zetof/herbs-with-brains/documents/cout-proto.ods

Coûts de construction de l'unité hydroponique – Prototype
Libellé | Prix unitaire | Quantité | Total | Remarque
Table à marée | 49,00 € | 1 | 49,00 € | bac récupérateur
Table de culture | 15,00 € | 1 | 15,00 € | bac semis
Armoire
Panneau OSB 3 | 24,90 € | 2 | 49,80 € | 3 plateaux
Chevron sapin 50x50 | 5,15 € | 2 | 10,30 € | 4 montants
Panneau polystyrène extrudé | 3,97 € | 6 | 23,82 € | 3 côtés
Plaque PMMA – plexiglas | 43,97 € | 1 | 43,97 € | 1mx1m, la porte doit être plus petite que prévue
 |  |  | 127,89 €
Cylindre de culture
PVC rigide 5mm 1mx1m | 45,00 € | 2 | 90,00 € | les deux portes tube circulaires
PVC rigide 5mm 1mx0,5m | 22,50 € | 1 | 22,50 € | les supports en croix haut et bas
Tuyau PVC rigide 100mm 4m | 5,50 € | 1 | 5,50 € | tube central
Tuyau PVC rigide 100mm 4m | 4,90 € | 5 | 24,50 € | tubes de culture
Roulette à bille | 1,69 € | 6 | 10,14 € | roulements
 |  |  | 152,64 €
Circulation eau
Pompe 1000l/h | 19,90 € | 1 | 19,90 €
Tuyau semi rigide 16mm / m | 0,90 € | 2 | 1,80 €
Tuyau PVC 4mm / m | 0,50 € | 10 | 5,00 €
Tête de distribution 12 sorties | 1,50 € | 1 | 1,50 €
Collier de serrage 16mm | 0,50 € | 2 | 1,00 €
 |  |  | 29,20 €
Sondes
pH + conductivity sensors | 99,00 € | 1 | 99,00 €
Humidité + température | 1,95 € | 1 | 1,95 €
Température de l'eau | 4,89 € | 1 | 4,89 €
Détection niveau d'eau | 1,65 € | 2 | 3,30 € | capteur haut et bas
 |  |  | 109,14 €
Actions
Résistance chauffante | 17,66 | 1 | 17,66 €
Ventilateur | 5,89 | 3 | 17,67 € | 2 pour l'unité plus une pour les alimentations
LED | 14,78 | 10 | 147,80 €
Électrovanne | 5,41 | 2 | 10,82 € | 12V DC – 1 pour le niveau d'eau, une pour le bac à semis
 |  |  | 193,95 €
Informatique
Raspberry PI | 39,9 | 1 | 39,90 €
Arduino uno | 7,59 | 2 | 15,18 €
 |  |  | 55,08 €
Alimentation
12v – 40A | 22,84 | 1 | 22,84 €
5v – 50W | 12,59 | 1 | 12,59 €
 |  |  | 35,43 €
 |  | TOTAL : | 767,33 €
