zetof/herbs-with-brains/freecad/modeles/assemblage.fcstd

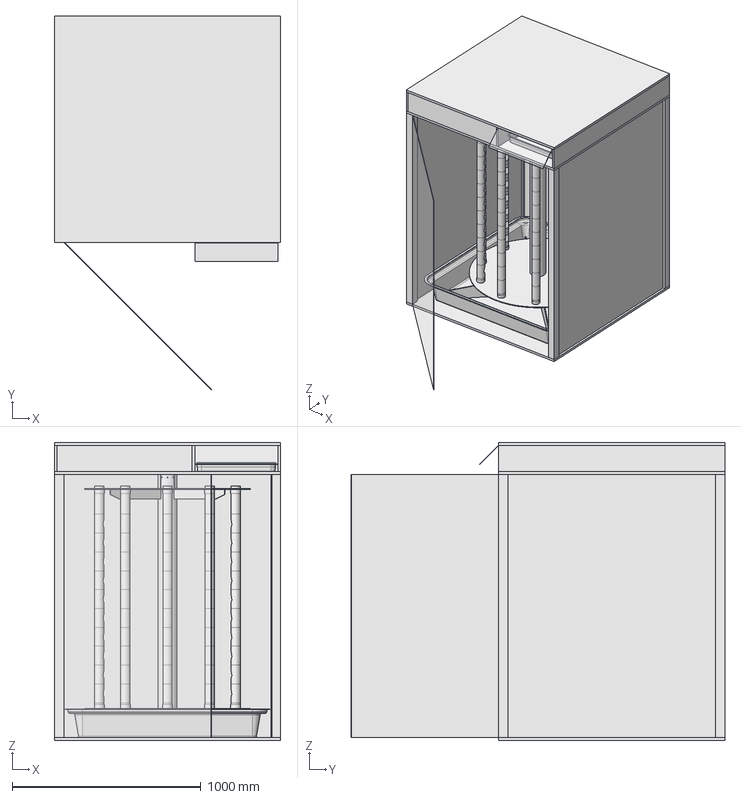
[picture p13: CAD file, 2016-10-27]
freecad/modeles/assemblage.fcstd
1200.0 x 1981.5 x 1580.0 mm
disque_inferieur
bille
corps
percage_base
bille001
corps001
percage_base001
bille002
corps002
percage_base002
bille003
corps003
percage_base003
bille004
corps004
percage_base004
bille005
corps005
percage_base005
porte_tubes_inferieur
porte_tubes_superieur
support_bas_1
support_bas_2
tube_culture_1
tube_culture_2
tube_culture_3
tube_culture_4
tube_culture_5
tube_culture_6
tube_culture_7
tube_culture_8
tube_culture_9
tube_culture_10
support_haut_1
support_haut_2
tube_central
plateau_bas
plateau_intermediaire
plateau_haut
bac_semis
bac_recuperateur
cote_droit
cote_gauche
face_avant
cote_arriere
cote_milieu
montant_arriere_gauche
montant_arriere_droit
montant_avant_gauche
montant_avant_droit
paroi_fond
paroi_droite
paroi_gauche
porte
porte_semis
