zetof/herbs-with-brains/freecad/export_assemblage/support_1.step

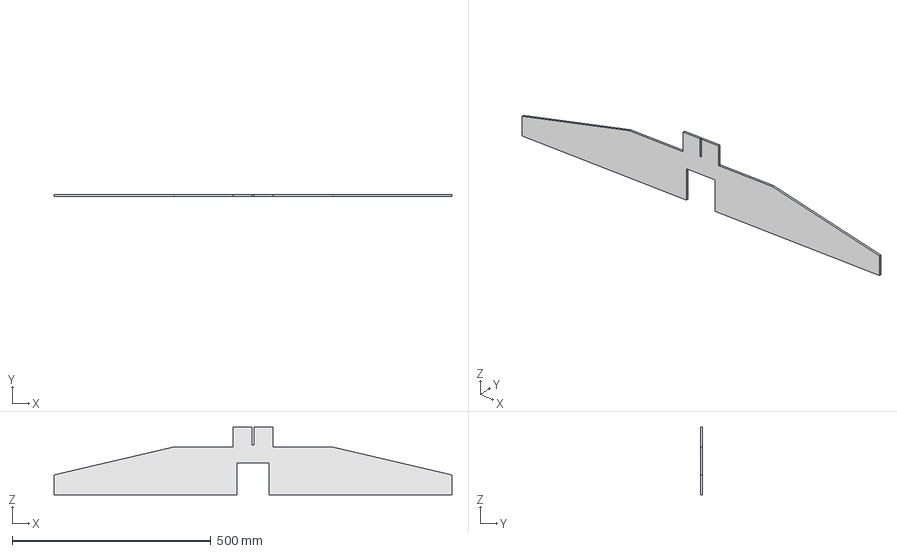
[picture p14: CAD file, 2016-12-03]
freecad/export_assemblage/support_1.step
1000.0 x 5.00 x 170.0 mm
