zetof/herbs-with-brains/freecad/export_assemblage/cote_superieur.step

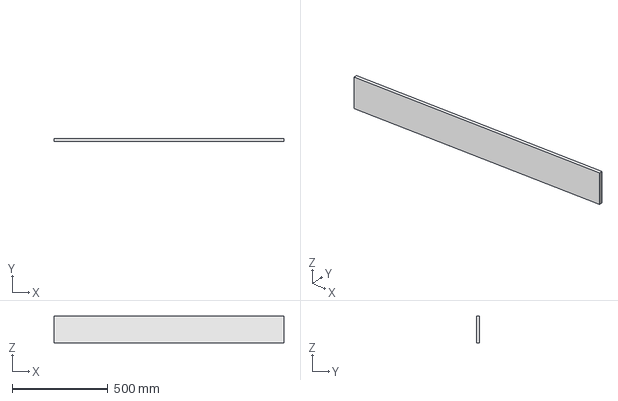
[picture p15: CAD file, 2016-10-27]
freecad/export_assemblage/cote_superieur.step
1200.0 x 15.0 x 140.0 mm
