zetof/herbs-with-brains/freecad/modeles/porte.fcstd

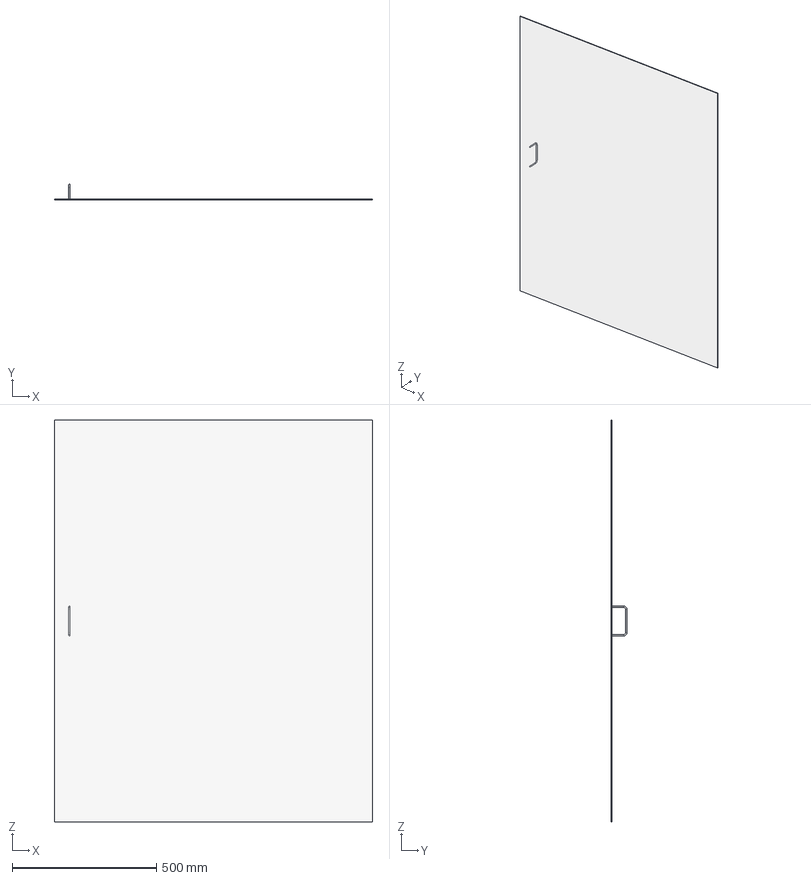
[picture p16: CAD file, 2016-10-27]
freecad/modeles/porte.fcstd
1105.0 x 55.5 x 1395.0 mm
porte
poignee
