zetof/herbs-with-brains/freecad/export_assemblage/face_avant.step

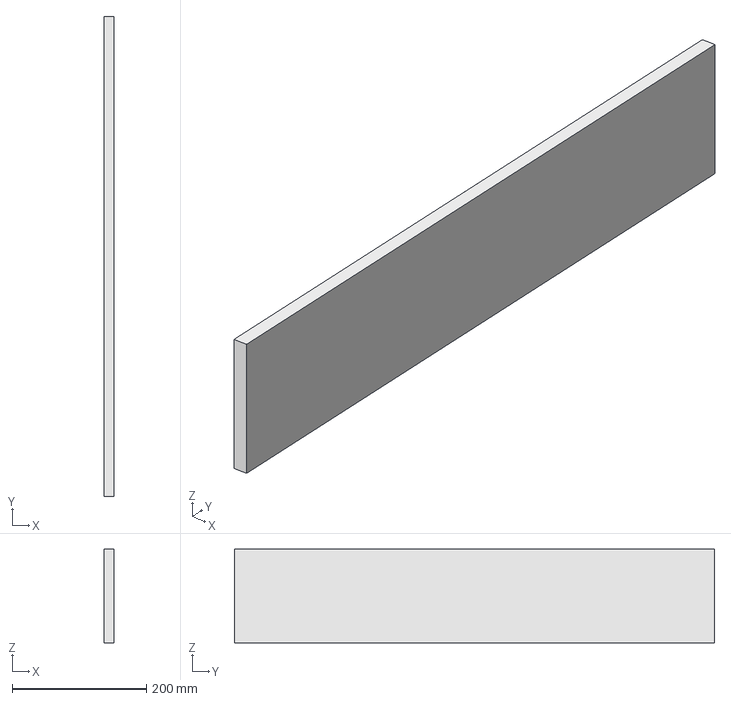
[picture p17: CAD file, 2016-10-27]
freecad/export_assemblage/face_avant.step
15.0 x 715.0 x 140.0 mm
