zetof/herbs-with-brains/freecad/modeles/bac.fcstd

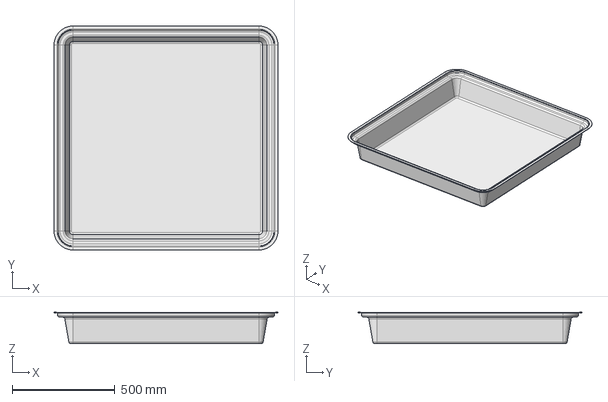
[picture p18: CAD file, 2016-10-27]
freecad/modeles/bac.fcstd
1088.0 x 1088.0 x 152.2 mm
