zetof/herbs-with-brains/freecad/export_assemblage/cote_superieur_milieu.step

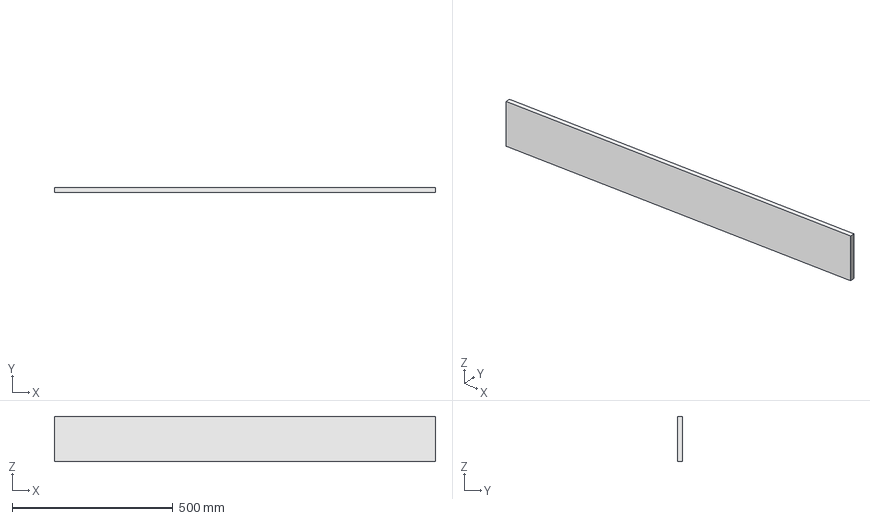
[picture p19: CAD file, 2016-10-27]
freecad/export_assemblage/cote_superieur_milieu.step
1185.0 x 15.0 x 140.0 mm
