zetof/herbs-with-brains/freecad/modeles/petit_bac.fcstd

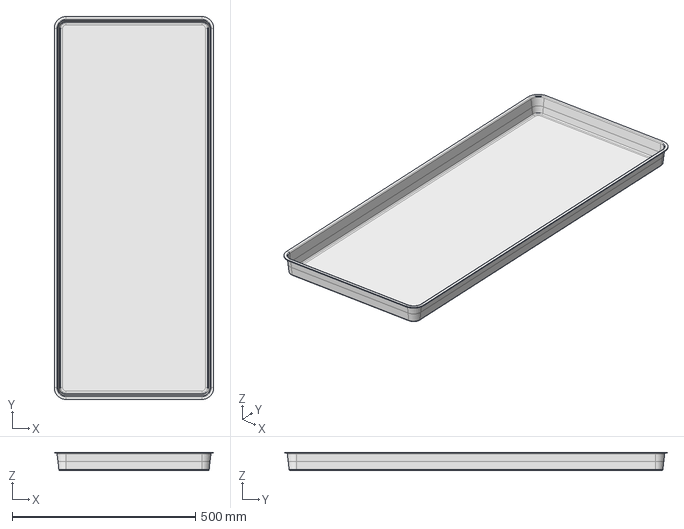
[picture p20: CAD file, 2016-10-27]
freecad/modeles/petit_bac.fcstd
435.3 x 1045.3 x 50.0 mm
