zetof/herbs-with-brains/freecad/export_assemblage/paroi.step

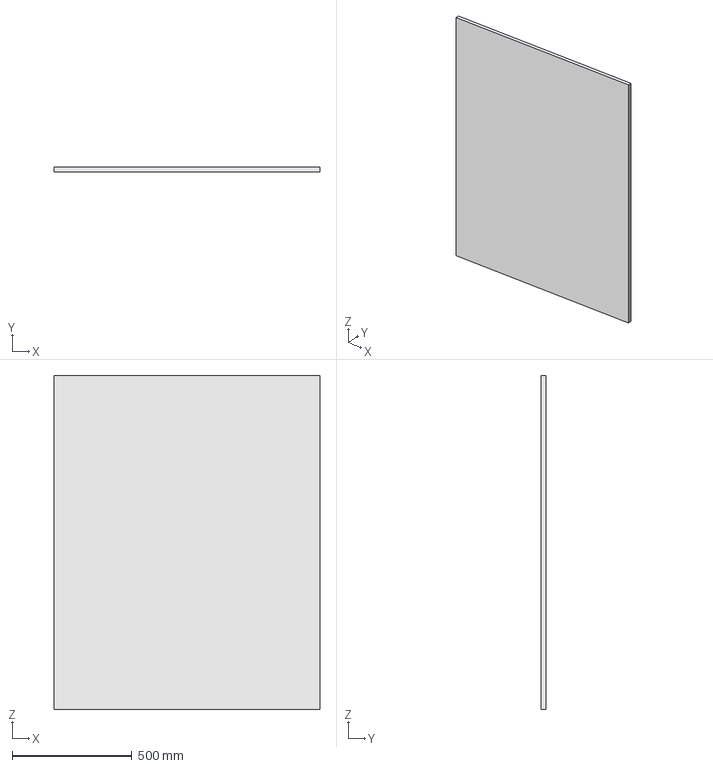
[picture p21: CAD file, 2016-10-27]
freecad/export_assemblage/paroi.step
1110.0 x 20.0 x 1395.0 mm
