zetof/herbs-with-brains/freecad/modeles/plateau_troue.fcstd

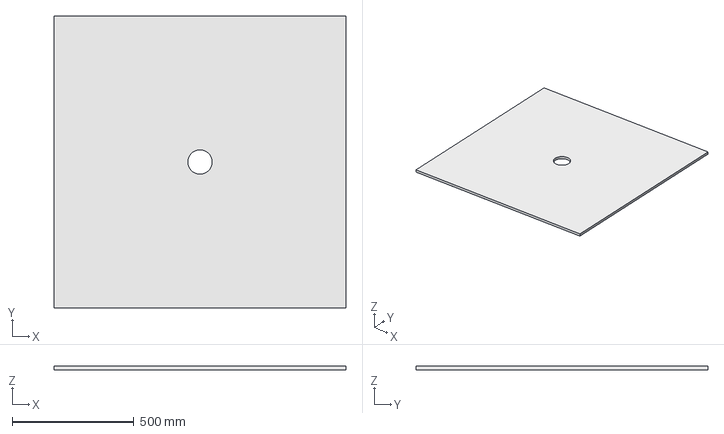
[picture p22: CAD file, 2016-10-27]
freecad/modeles/plateau_troue.fcstd
1200.0 x 1200.0 x 15.0 mm
