zetof/herbs-with-brains/freecad/export_assemblage/tube_central.step

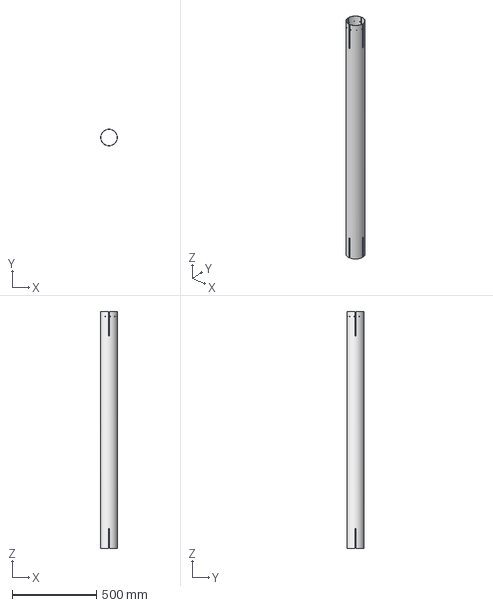
[picture p23: CAD file, 2016-10-27]
freecad/export_assemblage/tube_central.step
100.0 x 100.0 x 1410.0 mm
