zetof/herbs-with-brains/freecad/modeles/montant_3.fcstd

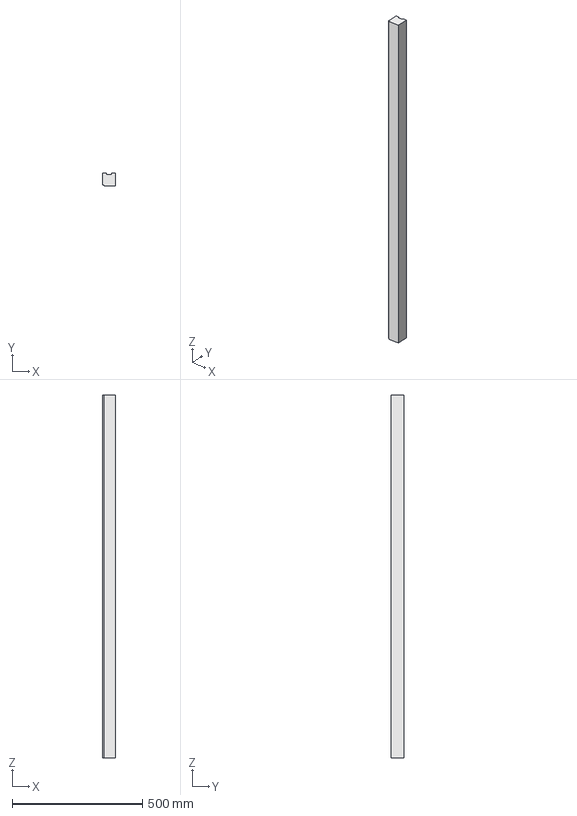
[picture p24: CAD file, 2016-10-27]
freecad/modeles/montant_3.fcstd
50.0 x 50.0 x 1395.0 mm
