zetof/herbs-with-brains/freecad/modeles/porte_semis.fcstd

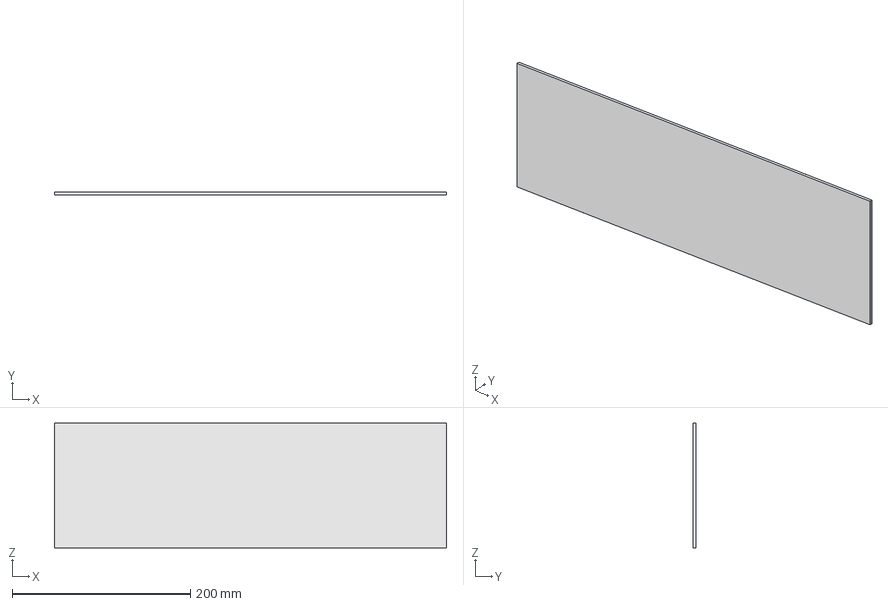
[picture p25: CAD file, 2016-10-27]
freecad/modeles/porte_semis.fcstd
440.0 x 3.00 x 140.0 mm
