zetof/herbs-with-brains/freecad/modeles/plateau.fcstd

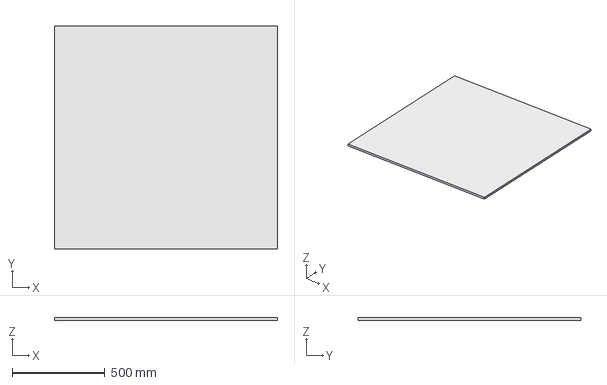
[picture p26: CAD file, 2016-10-27]
freecad/modeles/plateau.fcstd
1200.0 x 1200.0 x 15.0 mm
