zetof/herbs-with-brains/freecad/export_assemblage/montant.step

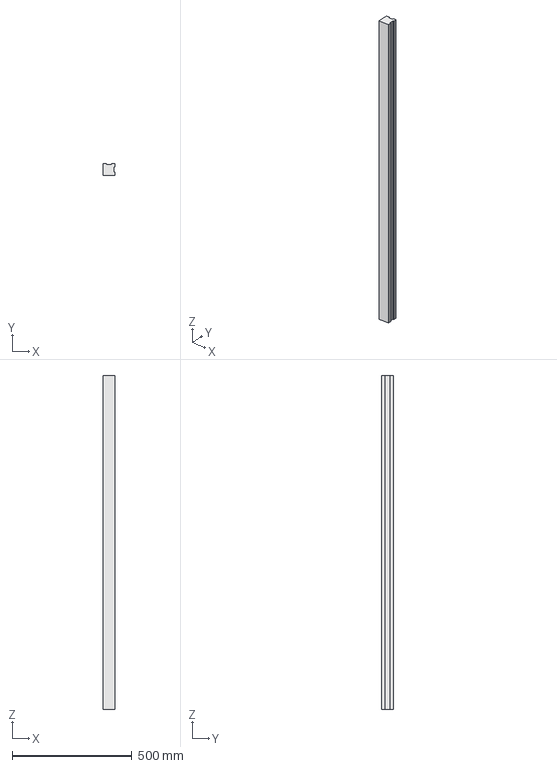
[picture p27: CAD file, 2016-10-27]
freecad/export_assemblage/montant.step
50.0 x 50.0 x 1395.0 mm
