zetof/herbs-with-brains/freecad/export_assemblage/support_h_1.step

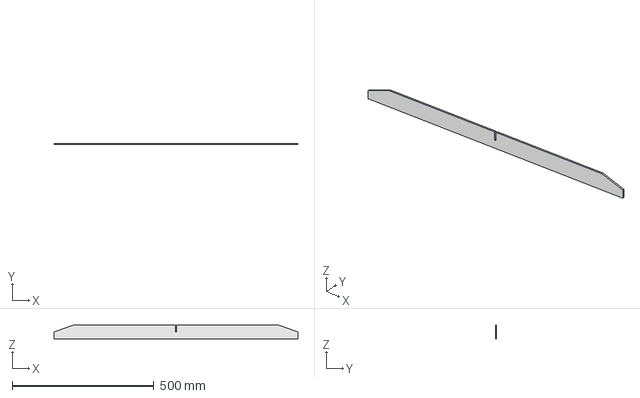
[picture p28: CAD file, 2016-10-25]
freecad/export_assemblage/support_h_1.step
860.0 x 5.00 x 50.0 mm
