zetof/herbs-with-brains/freecad/export_assemblage/porte_tubes.step

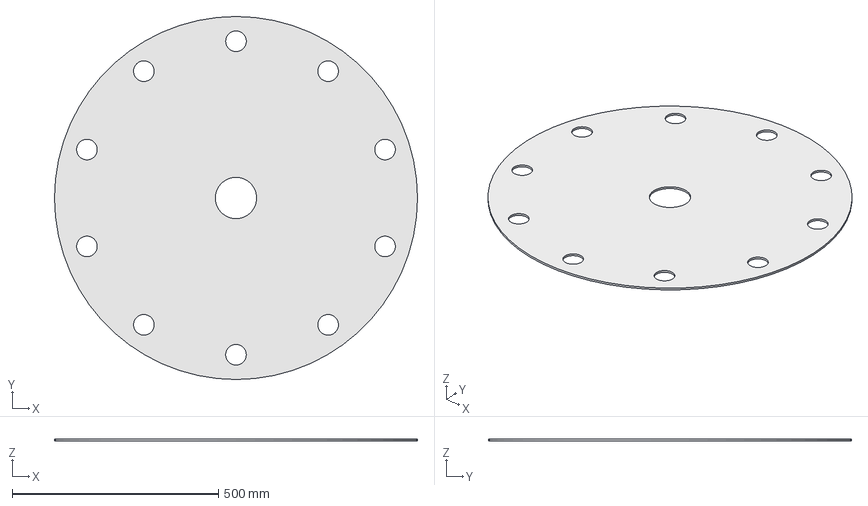
[picture p29: CAD file, 2016-10-25]
freecad/export_assemblage/porte_tubes.step
880.0 x 880.0 x 5.00 mm
