zetof/herbs-with-brains/freecad/export_assemblage/tube_culture.step

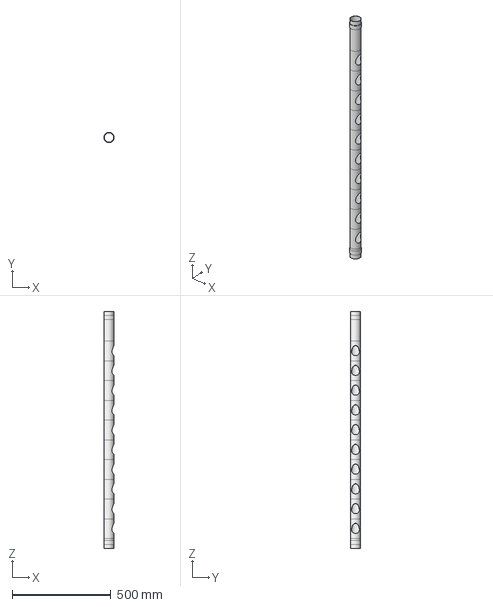
[picture p30: CAD file, 2016-10-25]
freecad/export_assemblage/tube_culture.step
52.9 x 53.0 x 1200.0 mm
