zetof/herbs-with-brains/freecad/export_assemblage/roulette_bille.step

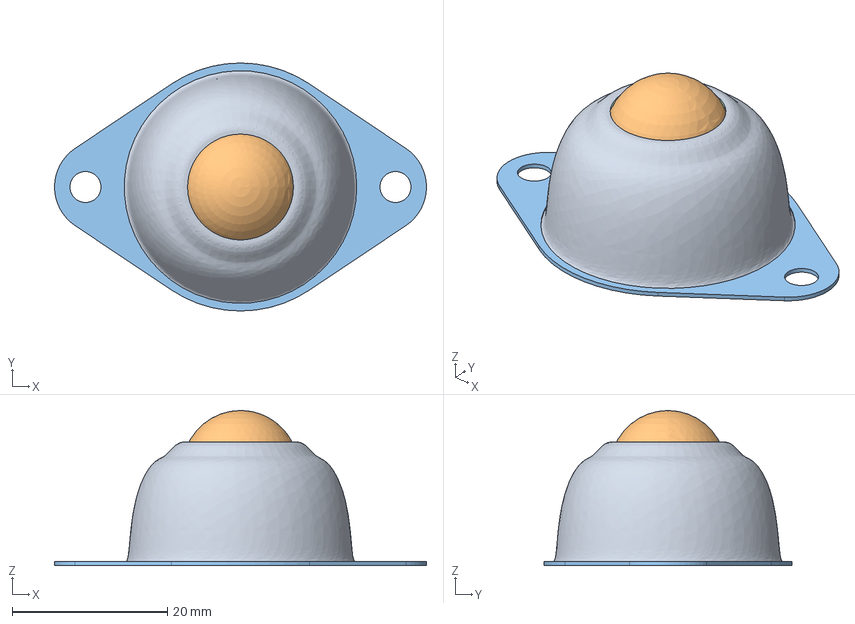
[picture p31: CAD file, 2016-10-25]
freecad/export_assemblage/roulette_bille.step
48.0 x 32.0 x 20.0 mm
bille
corps
percage_base
sphere_interieure
