zetof/herbs-with-brains/freecad/export_assemblage/disque_inferieur.step

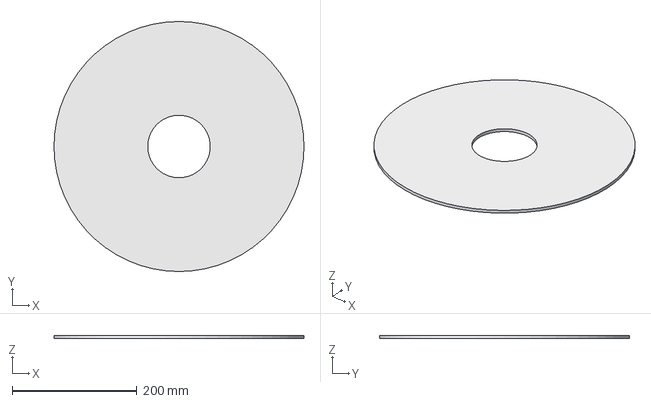
[picture p32: CAD file, 2016-10-25]
freecad/export_assemblage/disque_inferieur.step
400.0 x 400.0 x 5.00 mm
