zetof/herbs-with-brains/freecad/modeles/eclate.fcstd

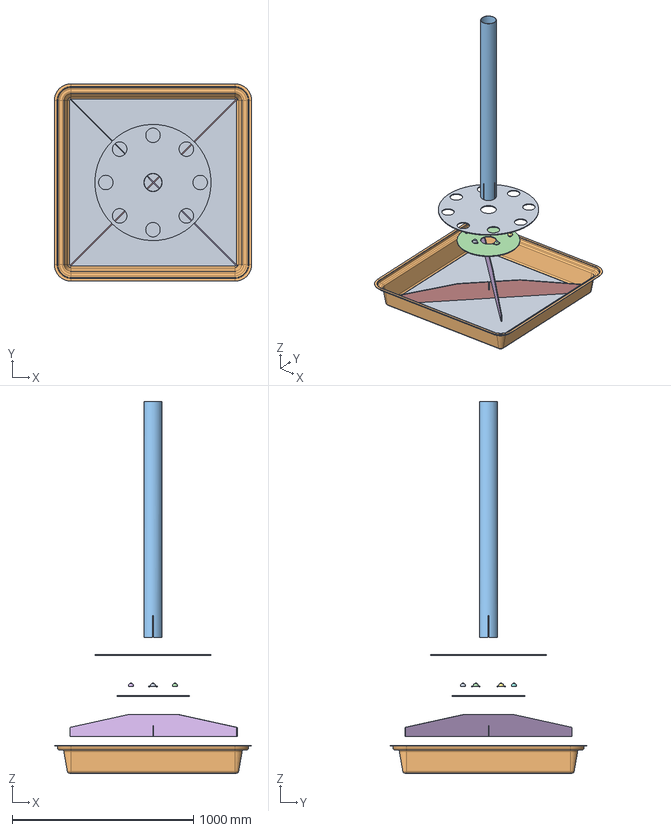
[picture p33: CAD file, 2016-10-25]
freecad/modeles/eclate.fcstd
1088.0 x 1088.0 x 2050.0 mm
fond
cotes
decoupes
disque_inferieur
support_1
support_2
bille
corps
percage_base
bille001
corps001
percage_base001
bille002
corps002
percage_base002
bille003
corps003
percage_base003
bille004
corps004
percage_base004
bille005
corps005
percage_base005
trous
