zetof/herbs-with-brains/(list of files, cad)

Other CAD files:
freecad/modeles/support_2.fcstd
freecad/export_assemblage/support_2.step
freecad/modeles/support_1.fcstd
freecad/modeles/cote_superieur_milieu.fcstd
freecad/export_assemblage/bac.step
freecad/modeles/face_avant.fcstd
freecad/export_assemblage/porte.step
freecad/export_assemblage/montant._2.step
freecad/export_assemblage/montant._3.step
freecad/export_assemblage/porte_semis.step
freecad/modeles/paroi.fcstd
freecad/export_assemblage/petit_bac.step
freecad/modeles/cote_superieur.fcstd
freecad/export_assemblage/plateau_troue.step
freecad/modeles/montant_2.fcstd
freecad/modeles/tube_central.fcstd
freecad/modeles/montant.fcstd
freecad/export_assemblage/support_h_2.step
freecad/modeles/support_h_1.fcstd
freecad/modeles/support_h_2.fcstd
freecad/modeles/porte_tubes.fcstd
freecad/modeles/roulette_bille.fcstd
freecad/modeles/disque_inferieur.fcstd
freecad/modeles/tube_culture.fcstd
freecad/modeles/bac_fusion.fcstd
