zetof/herbs-with-brains/marketting/herbs-with_brains.pdf

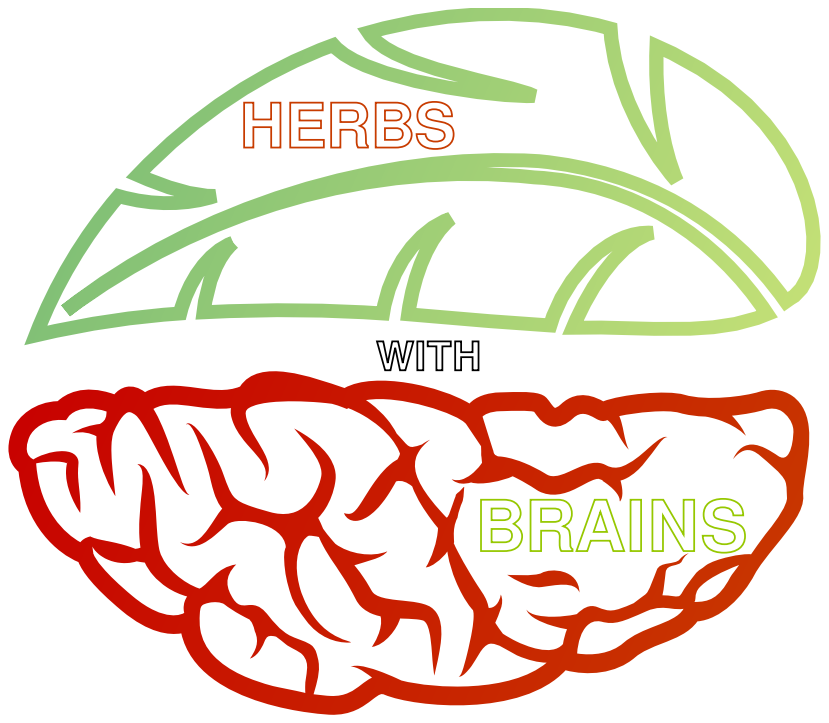
[picture p34: page 1]
