zetof/herbs-with-brains/(list of files, drawings)

Other design files:
fritzing/arduino-lcd-display.fzz
fritzing/communication_i2c.fzz
