zetof/herbs-with-brains/(commit log)

2016-10-25 Ajout des documents
    [assemblage.fcstd, bac.fcstd, bac.step, bac_fusion.fcstd, disque_inferieur.fcstd, disque_inferieur.step, eclate.fcstd, porte_tubes.fcstd]
2016-10-25 Diminution des supports supérieurs pour maximiser la lumière
    [assemblage.fcstd, support_h_1.fcstd, support_h_1.step, support_h_2.fcstd, support_h_2.step, tube_central.fcstd, tube_central.step]
2016-10-27 Caisse, bas à semis et finalisation du chassis
    [assemblage.fcstd, bac.fcstd, bac.step, cote_superieur.fcstd, cote_superieur.step, cote_superieur_milieu.fcstd, cote_superieur_milieu.step, face_avant.fcstd]
2016-10-28 Première proposition de logo
2016-11-03 Calcul du coût du prototype
    [cout-proto.ods]
2016-11-08 Procédure d'installation du Raspberry Pi
2016-11-09 Complétion de la procédure d'installation du Raspberry Pi
2016-11-10 Procédure d'installation du Raspberry Pi étoffée
2016-11-14 Procédure d'installation du Raspberry modifiée
2016-12-03 Modifications de l'unité suite à montage du proto
    [support_1.fcstd, support_1.step, support_2.fcstd, support_2.step]
2016-12-03 Suppression de l'installation du Raspberry Pi car explicitée sur le blog
2016-12-03 Ajout des schémas de connexion réalisés avec Fritzing
    [arduino-lcd-display.fzz, communication_i2c.fzz]
2016-12-03 Ajout des scripts bash utilisés dans le cadre du projet afin d'automatiser certaines tâches
2016-12-03 Ajout des scripts Python du Raspberry
2016-12-03 Ajout des sources pour l'Arduino 1
2017-01-09 Passage du panneau des alarmes sur Raspberry Pi
2017-01-09 Pour mémo, ancienne gestion du panneau des alarmes via Arduino
2017-01-12 Configuration VIM sur le Raspberry
2017-01-12 Scripts TMUX et d'échange de fichiers mis à jour
2017-01-12 Modifications code Arduino pour Platformio
2017-01-12 Ajout du Daemon de communication USB
2017-01-14 Mise en place des observateurs pour la communication USB + maj des scripts avec ajout des paramètres
2017-01-20 Communication USB avec plusieurs arduinos, sécurisée et gestion des alarmes sur raspberry
2017-01-24 Base de la plate-forme Arduino améliorée
2017-01-25 Internationalisation et amélioration de la communication
    [language.cfg]
2017-01-31 Ajout des services internet + fiabilisation de la communication USB
2017-02-01 Base de la plate-forme de développement OK
    [language.cfg]
2017-02-07 Ajout de l'objet de stockage des paramètres + menu complet
    [language.cfg, menu.cfg]
